ece-student/Team-16/docs/MeetingMinutes/oct27.md

Finished the SPI stuff yesterday, currently working on finishing up lab 4 FPGA stuff.
