ece-student/Team-16/docs/MeetingMinutes/oct13.md

Agenda
* Continue working on lab3
    Especially try to figure out how the pin connections on the FPGA work
* Work on the report for lab3
