ece-student/Team-16/docs/MeetingMinutes/sep29.md

# Meeting Agenda 

-  **Work on lab3** start looking through the material
-  **Fill out team evaluation form** 
-  **Add more demo for milestone2** 

Graphics team | Acoustic team
------------ | -------------
Lois | John
Jidenna | Asad
Firehiwot | Rohit
