ece-student/Team-16/docs/MeetingMinutes/sep22.md

Meeting Minute 9/22

  * We moved around some things on the Milestone 1.
  
  * Added the circuit diagram to the Milestone.
  
  * Finish up Lab 2 writeup  
  
  * We started soldering the filter amp to make it more compact
  
  * We also started the 2nd milestone but we completed one sensor
  
### Next:
  * 2 side sensors and turn mechanism
  * Finish soldering
  * Rearrange wiring 

Meet tomorrow at 3PM
