ece-student/Team-16/docs/MeetingMinutes/sep2.md

Meeting minutes 9/2
Meeting day will be Tuesday 7pm ECE lounge

The lab will be graded in terms of the following: [Lab Grading](https://cei-lab.github.io/ece3400/Grading/Lab_score.html) 

## Task Division

* 2 points: Blinking an internal LED - (Jidenna)

* 2 points: Blinking an external LED- (Jidenna)

* 2 points: Reading the value of a potentiometer via the serial port (Asad)

* 2 points: Map the value of the potentiometer to the LED (Lois)

* 2 points: Map the value of the potentiometer to the servo (Firehiwot)

* 2 points: Assemble your robot (Rohit)

* 3 points: Driving your robot autonomously (John)

[CALENDAR](https://teamup.com/kshx1ageh1yif5gske)
