ece-student/Team-16/docs/MeetingMinutes/nov27.md

Meeting minute 11/27
Last week things to do
  * Backtracking algorithm
  * Rewiring
  * Radio communication
  * Start signal from mic
  * Merging codes and DFS algorithm
  * Mux
  
 Hardware Team
 * Jidenna
 * Asad
 * John
 
 Software Team
 * Lois 
 * Rohit
 * Firehiwot
 
 Final Report
 * Make graphics for robot and overall system
 * Explain hardaware components
 * Explain about issues ecountered during design
 * Take measurements of robot speed, line sensor threshold ...
