ece-student/Team-16/docs/FinalSystemDesign/after2.png

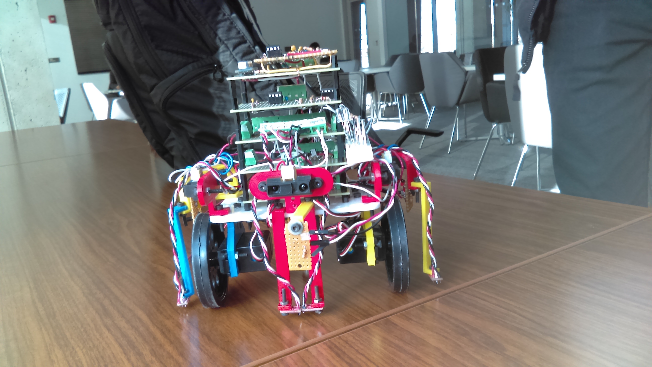
docs/FinalSystemDesign/after2.png
