ece-student/Team-16/docs/FinalSystemDesign/meme.png

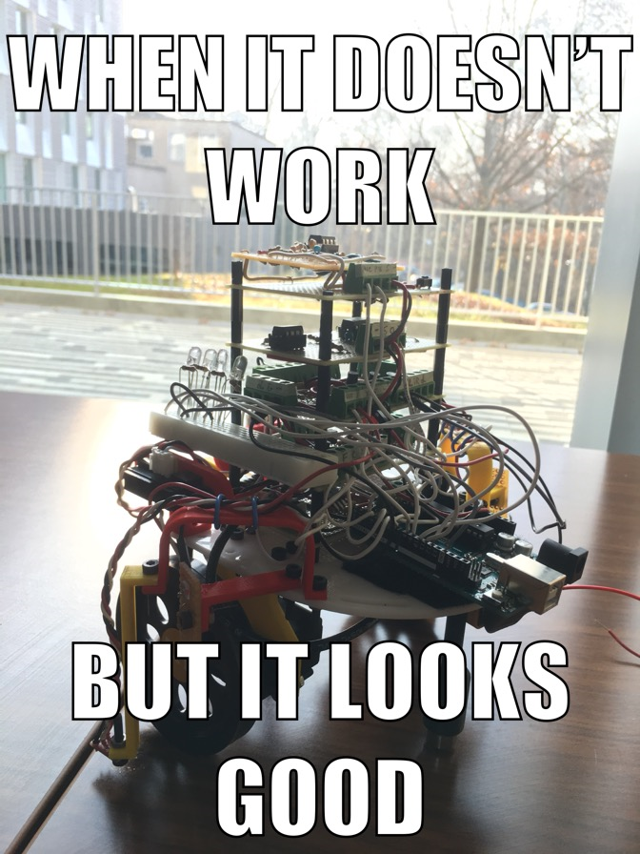
docs/FinalSystemDesign/meme.png
