ece-student/Team-16/docs/FinalSystemDesign/WallSensorAmplifier.png

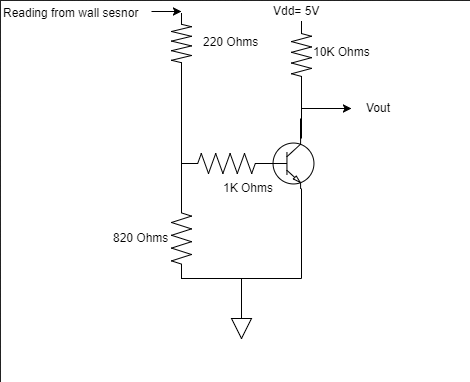
docs/FinalSystemDesign/WallSensorAmplifier.png
