ece-student/Team-16/docs/FinalSystemDesign/z.png

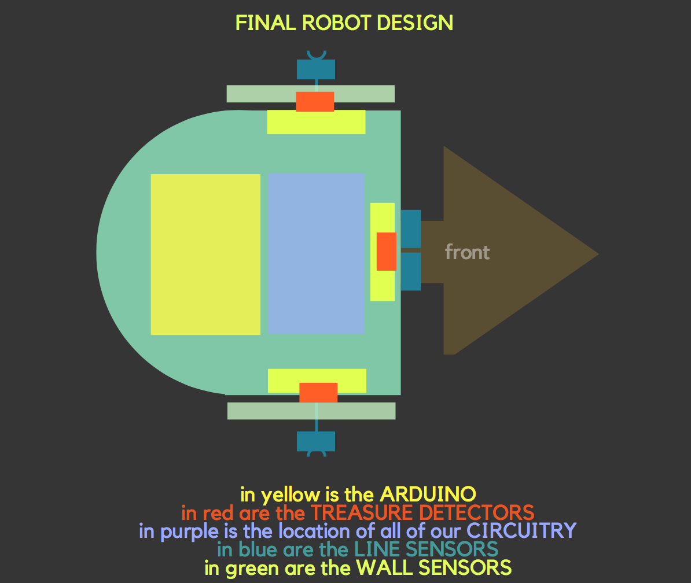
docs/FinalSystemDesign/z.png
