ece-student/Team-16/docs/lab1/imagesLab1/PotReading.png

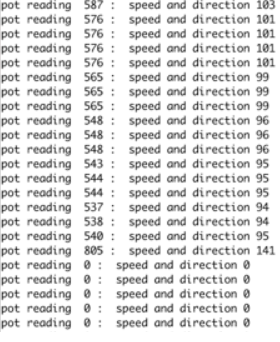
docs/lab1/imagesLab1/PotReading.png
