ece-student/Team-16/docs/lab1/imagesLab1/ServoandPot.png

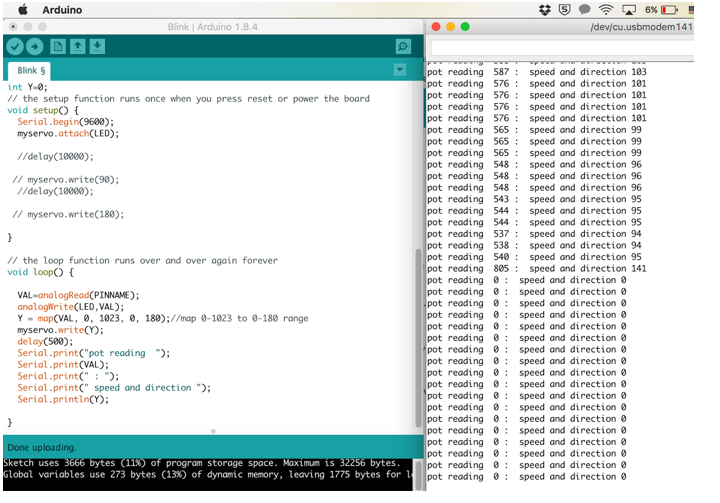
docs/lab1/imagesLab1/ServoandPot.png
