ece-student/Team-16/docs/lab2/1fdf49493ff94520a2393f6a7851c8cf.jpeg

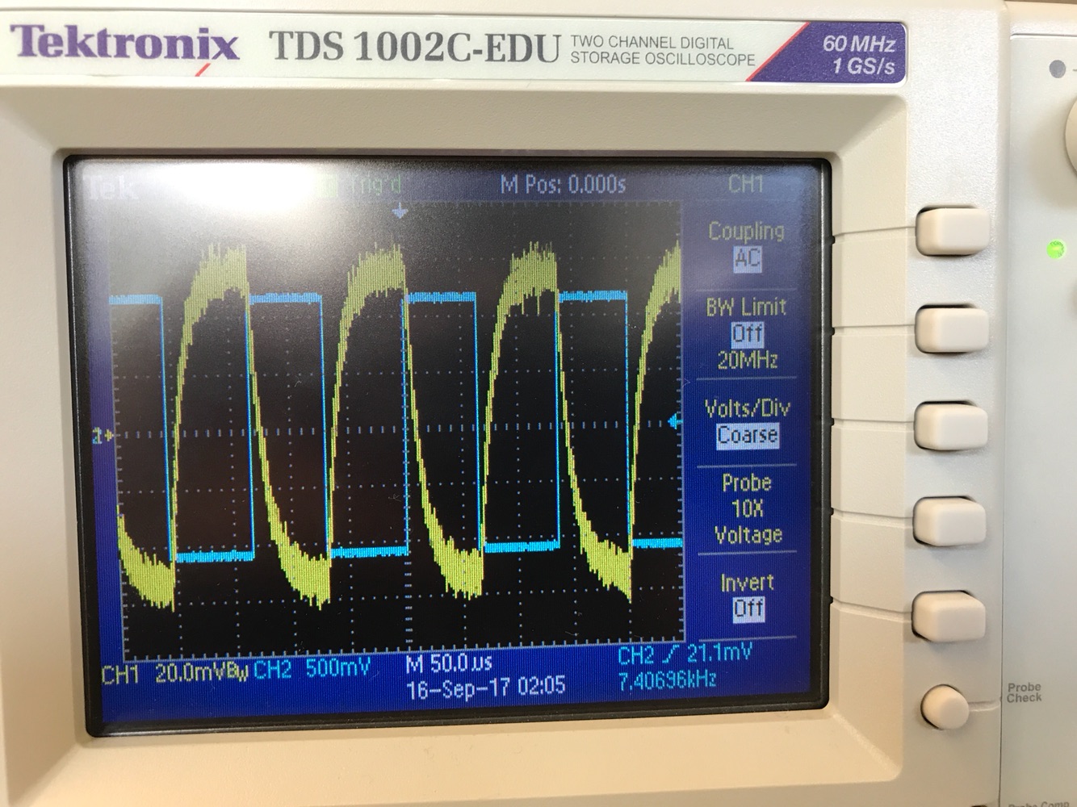
docs/lab2/1fdf49493ff94520a2393f6a7851c8cf.jpeg
