ece-student/Team-16/docs/lab2/baba.png

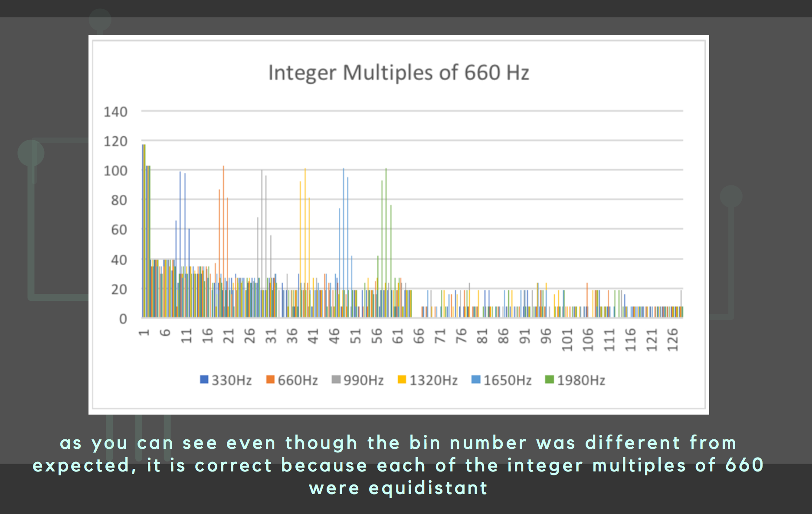
docs/lab2/baba.png
