ece-student/Team-16/docs/lab2/circuit.png

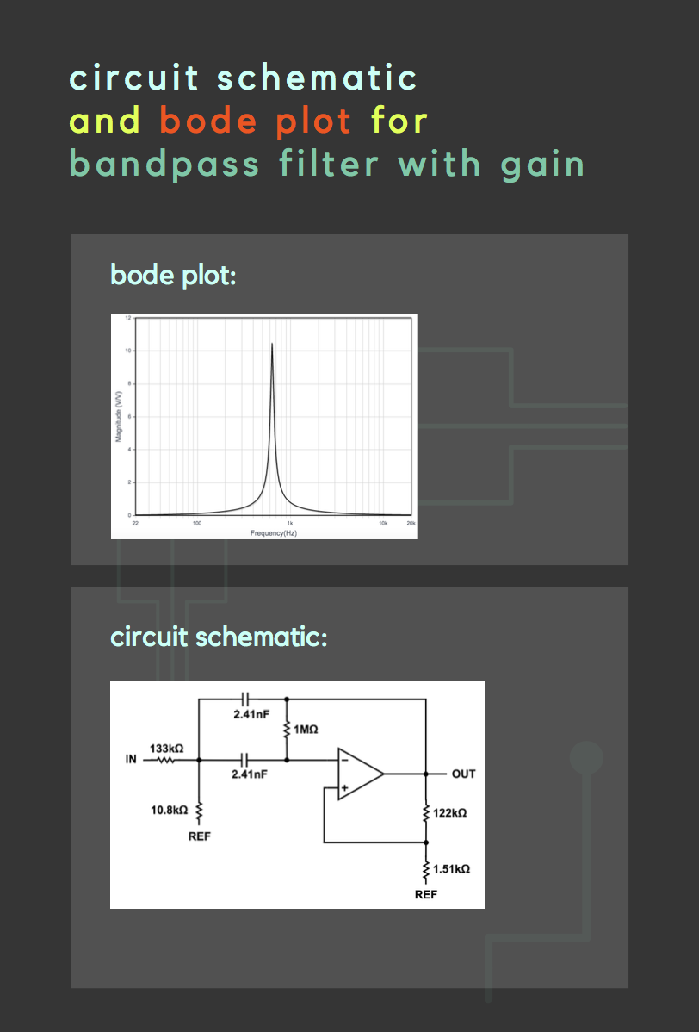
docs/lab2/circuit.png
