ece-student/Team-16/docs/lab2/d4d60459c0ec4c0591ddcf63fce9333b.jpeg

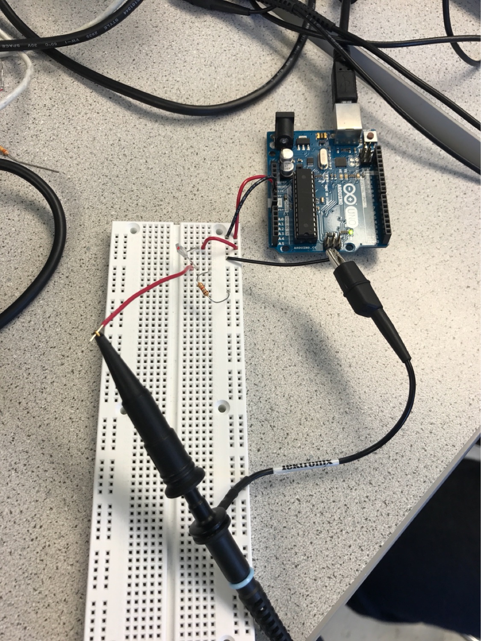
docs/lab2/d4d60459c0ec4c0591ddcf63fce9333b.jpeg
