ece-student/Team-16/docs/lab2/fun_gen.jpg

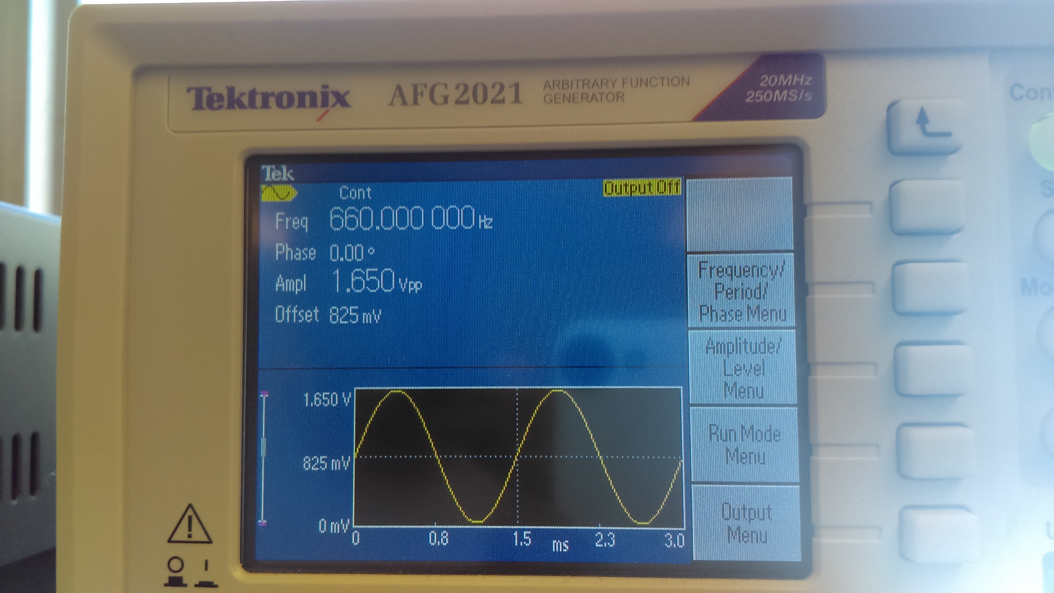
docs/lab2/fun_gen.jpg
