ece-student/Team-16/docs/lab3/acoustic_pics/Photo Oct 13, 3 56 24 PM (1).jpg

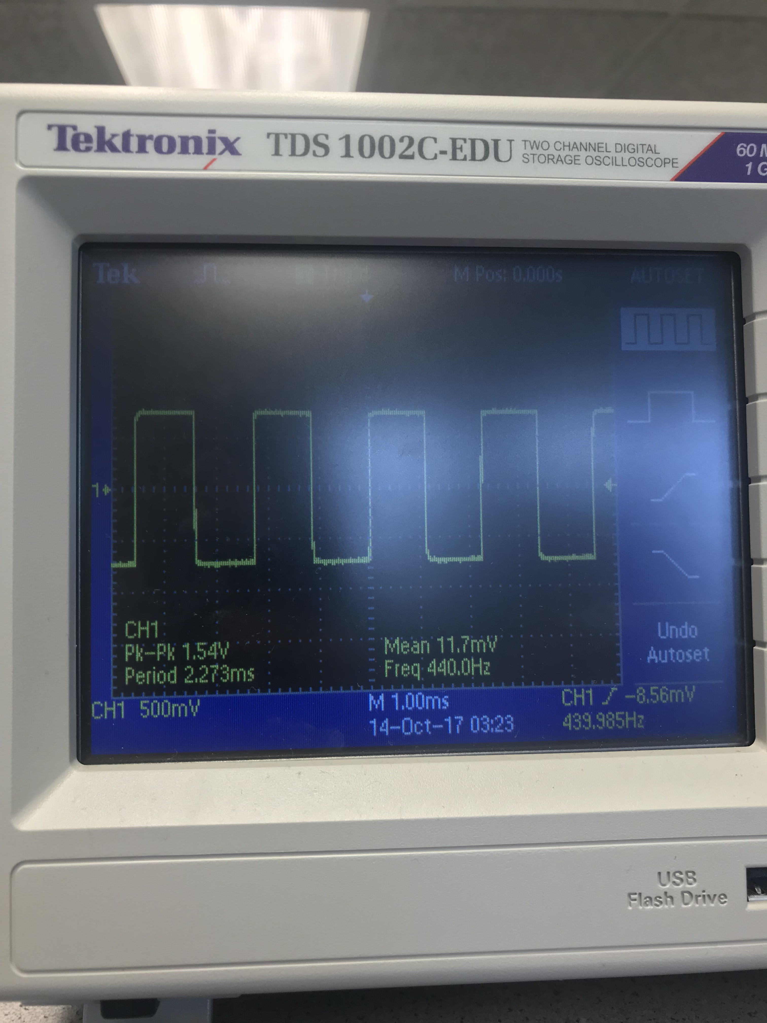
docs/lab3/acoustic_pics/Photo Oct 13, 3 56 24 PM (1).jpg
