ece-student/Team-16/docs/lab3/acoustic_pics/Photo Oct 13, 3 57 23 PM (1).jpg

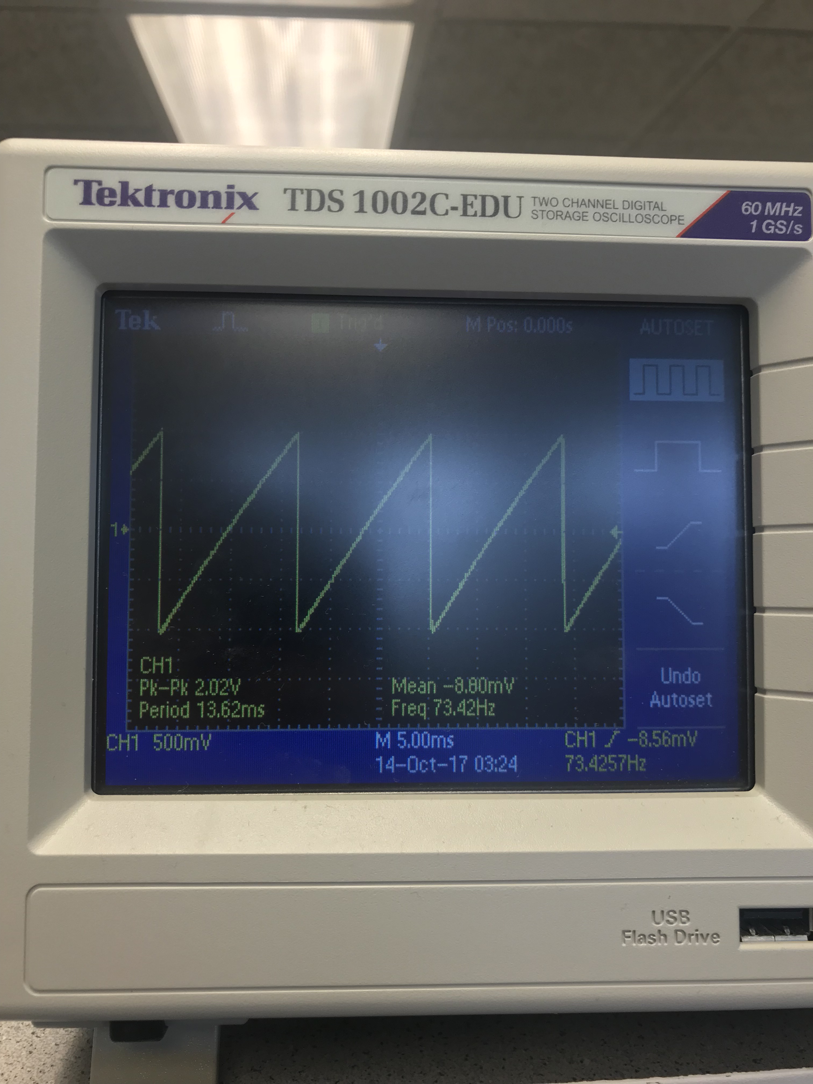
docs/lab3/acoustic_pics/Photo Oct 13, 3 57 23 PM (1).jpg
