ece-student/Team-16/docs/lab3/acoustic_pics/Photo Oct 13, 3 59 01 PM.jpg

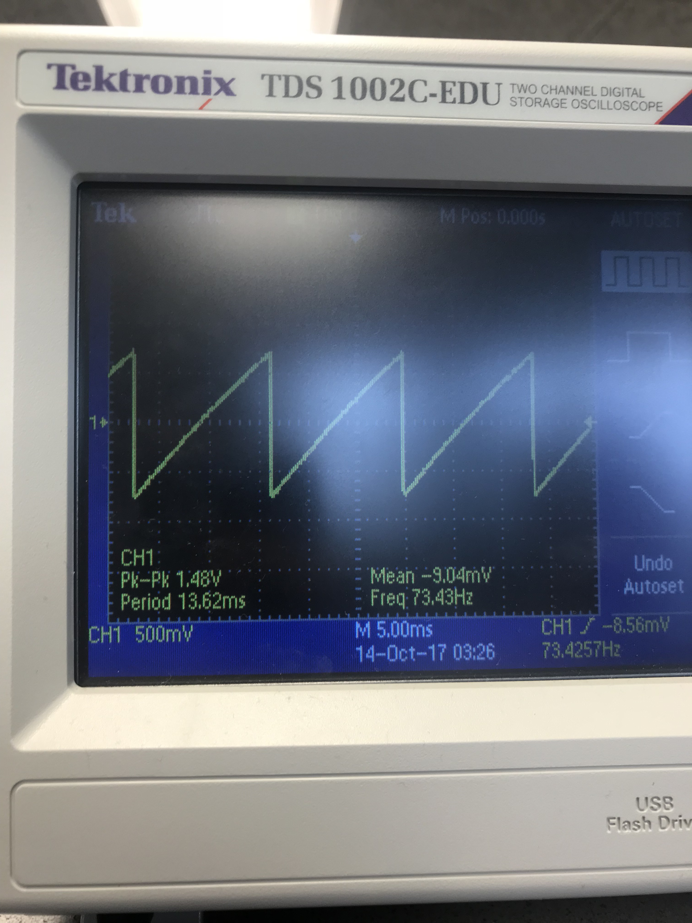
docs/lab3/acoustic_pics/Photo Oct 13, 3 59 01 PM.jpg
