ece-student/Team-16/docs/lab4/1.png

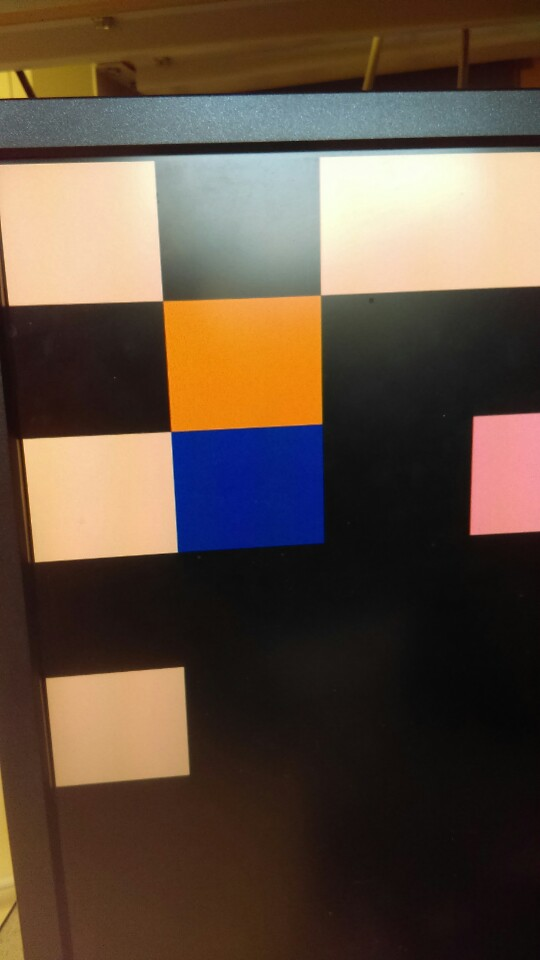
docs/lab4/1.png
