ece-student/Team-16/docs/lab4/2.png

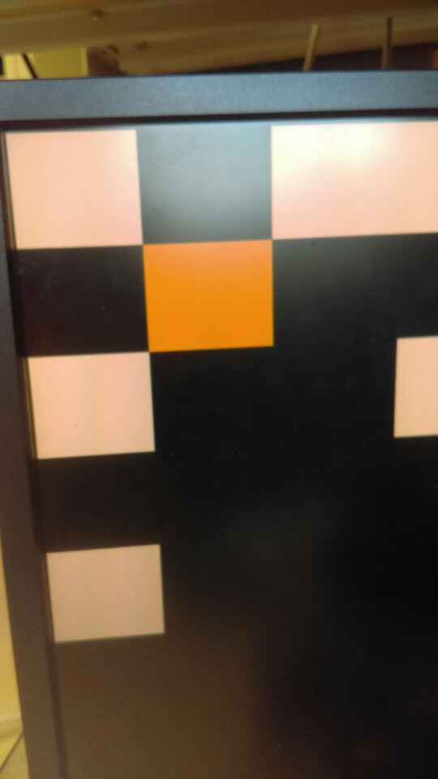
docs/lab4/2.png
