ece-student/Team-16/docs/lab4/VGA Display Pics/Image-1-3.jpg

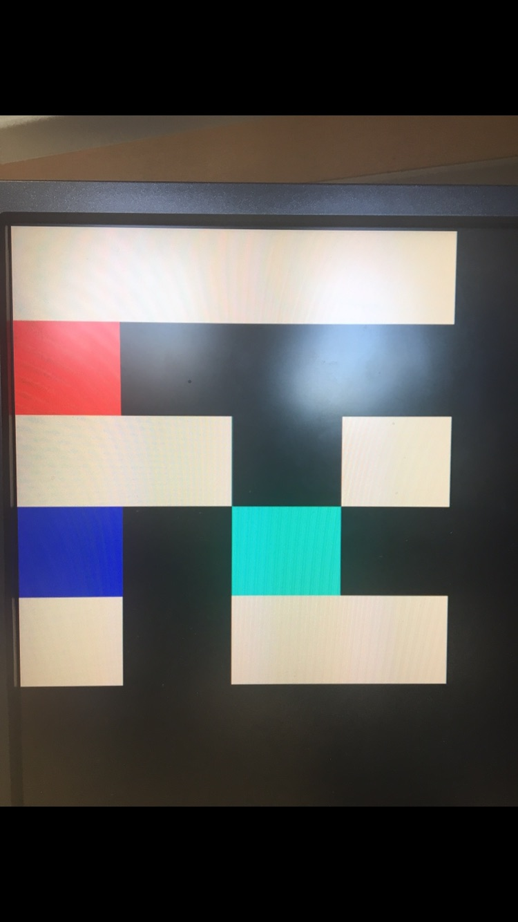
docs/lab4/VGA Display Pics/Image-1-3.jpg
