ece-student/Team-16/docs/milestone4/z1.png

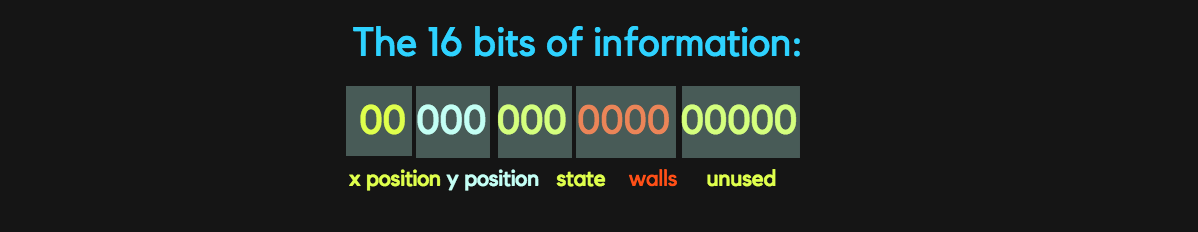
docs/milestone4/z1.png
