ece-student/Team-16/docs/milestone4/z2.png

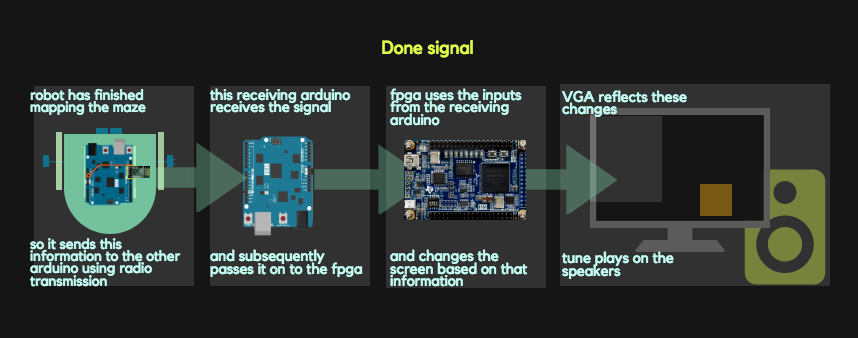
docs/milestone4/z2.png
