ece-student/Team-16/h/j.png

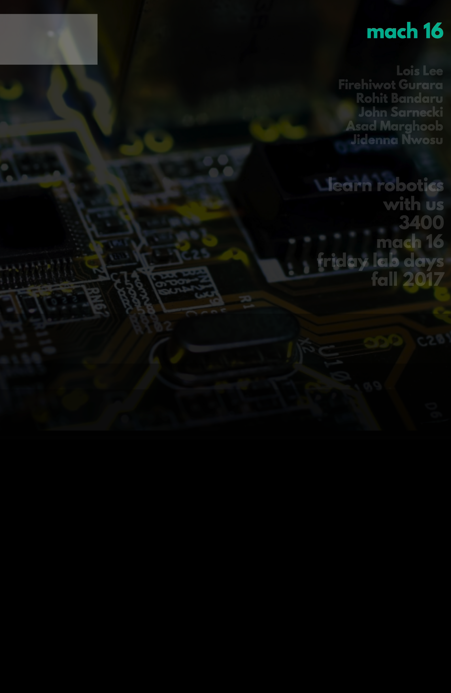
h/j.png
