ece-student/Team-16/h/mach.png

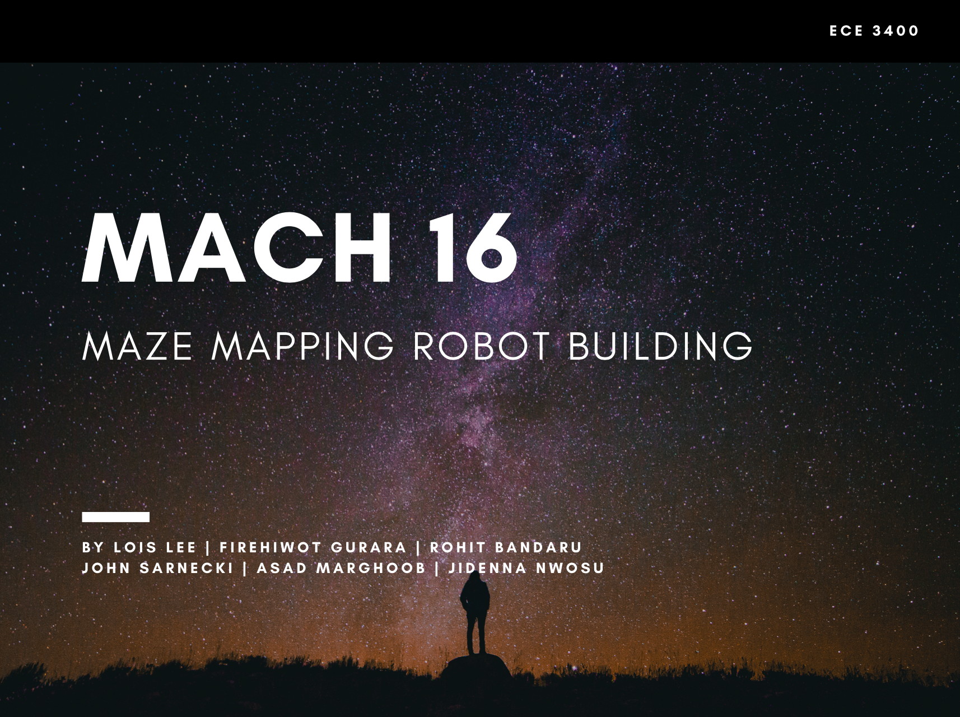
h/mach.png
