ece-student/Team-16/h/t.png

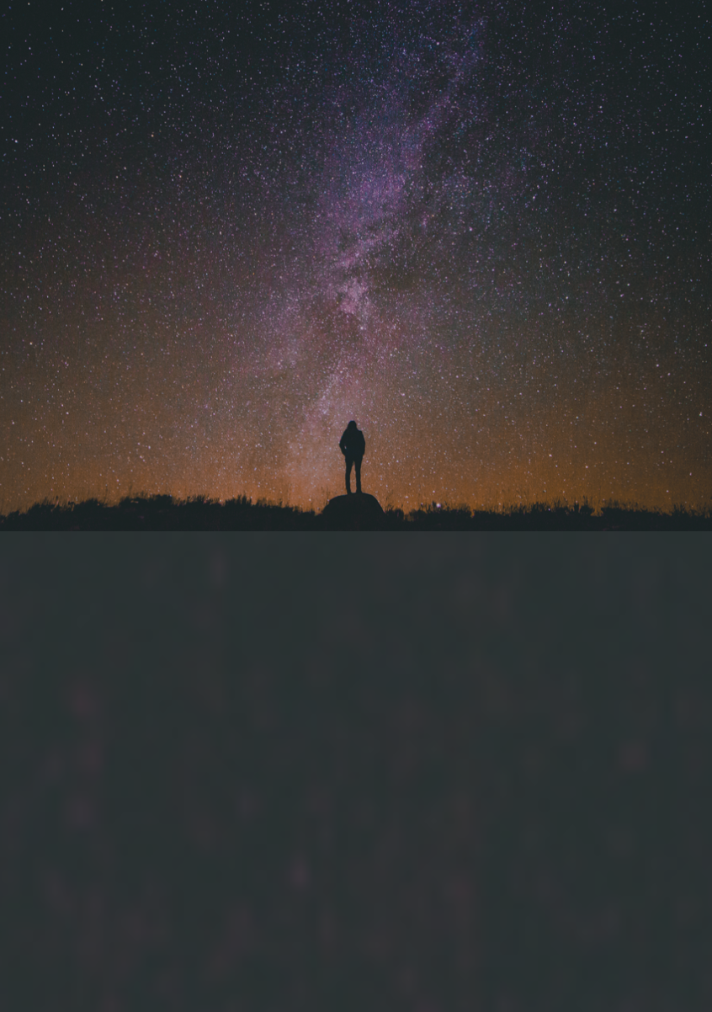
h/t.png
