ece-student/Team-16/docs/Milestone3/realDFS/changes.txt

if (robotX == NULL && robotY == NULL) {
      robotX = 3;
      robotY = 4;
      visited[robotY][robotX] = 6;
    } 
    else {
      visited[yfront][xfront]=6;
      visited[robotY][robotX] = 1;
      robotX = xfront;
      robotY = yfront;
    }    
    
    if (robotX == NULL && robotY == NULL) {
      robotX = 3;
      robotY = 4;
      visited[robotY][robotX] = 6;
    } 
    else {
      visited[yleftt][xleftt]=6;
      visited[robotY][robotX] = 1;
      robotX = xleftt;
      robotY = yleftt;
    }    

word assemble(word x, word y) {
word xShift = x;
xShift << 14;
word yShift = y;
yShift << 11;
word base = xShift || yShift;
base = base || (visited[y][x] << 8);
base = base || (wall[y][x] << 4); 
}
