ece-student/Team-16/docs/milestone4/finalized_robot_code/dumdum.ino

/* 
 *    Maze mapping Robot
 *  
 *  
 *  
 *  
 *  
 */

#include <Servo.h>


/**************************************************************************************Pin assignments*/
// Pin Assignments
const int rightServoPin = 6;
const int leftServoPin = 5;

const int middleRightPin = A2;
const int middleLeftPin = A1;
const int outerRightPin = A5;
const int outerLeftPin = A3;

const int ledPin = 13;

const int frontWall = 4;
const int leftWall = 3;
const int rightWall = 7;

Servo rightServo;
Servo leftServo; 


// Constants
#define WALL_NORTH  1 // 0001
#define WALL_EAST   2 // 0010
#define WALL_SOUTH  4 // 0100
#define WALL_WEST   8 // 1000

const int threshold = 800; 

const int delayTime = 2;

typedef enum {
              NORTH = 1,
              EAST  = 2,
              SOUTH = 4,
              WEST  = 8,
              } ORIENTATION;

typedef enum {
              FORWARD = 0,
              LEFT  = 1,
              RIGHT = 2,
              } TURN;

/*************************************************************************************Global variables*/
// Global Variables
int leftServoAngle = 90;
int rightServoAngle = 90;

int middleLeftVal = 0;
int middleRightVal = 0;
int outerLeftVal = 0;
int outerRightVal = 0;

int visitedBox = 0;

byte robotX = 3;
byte robotY = 4;

byte pastPosX = NULL;
byte pastPosY = NULL;

byte robotOrientation = NORTH;

byte xleft=robotX;
byte yleft=robotY;
byte xfront=robotX;
byte yfront=robotY;
byte xright=robotX;
byte yright=robotY;
byte xback=robotX;
byte yback=robotY;

bool detectNoFWall = true;
bool detectNoRWall = true;
bool detectNoLWall = true;
bool accessGranted = false;
bool doOpposite    = true;

//so goes front, left, right, opposite don't care about visited only walls
//how keep index?
//how know done? 
//is stack necessary?

byte visited[5][4] =  {{0,0,0,0},
                       {0,0,0,0},
                       {0,0,0,0},
                       {0,0,0,0},
                       {0,0,0,6}};

byte wall[5][4] = {{9,1,1,3},
                   {8,0,0,2},
                   {8,0,0,2},
                   {8,0,0,2},
                   {12,4,4,6}};


int rightServoMap(int angle) {
  int newAngle = 180 - angle;
  return newAngle;
}

void rightOrientation(){
  if(robotOrientation == NORTH){
    robotOrientation = EAST;
  }
  else if(robotOrientation == EAST) {
    robotOrientation = SOUTH;
  }
  else if(robotOrientation == SOUTH) {
    robotOrientation = WEST;
  }
  else if(robotOrientation == WEST) {
    robotOrientation = NORTH;
  }
}

void leftOrientation(){
  if(robotOrientation == NORTH){
    robotOrientation = WEST;
  }
  else if(robotOrientation == WEST) {
    robotOrientation = SOUTH;
  }
  else if(robotOrientation == SOUTH) {
    robotOrientation = EAST;
  }
  else if(robotOrientation == EAST) {
    robotOrientation = NORTH;
  }
}

bool withinMazeX(byte xCoord) {
  if(xCoord > 3 || xCoord < 0) {
    return false;
  } else {
    return true;
  } 
}

bool withinMazeY(byte yCoord) {
  if(yCoord > 4 || yCoord < 0) {
    return false;
  } else {
    return true;
  } 
}

//OK
void neighbourIndex(){
  if(robotOrientation == NORTH){
     xleft=robotX-1;
     yleft=robotY;
     xfront=robotX;
     yfront=robotY-1;
     xright=robotX+1;
     yright=robotY;
     xback=robotX;
     yback=robotY+1;
  }
  if(robotOrientation == EAST) {
     xleft=robotX;
     yleft=robotY-1;
     xfront=robotX+1;
     yfront=robotY;
     xright=robotX;
     yright=robotY+1;
     xback=robotX-1;
     yback=robotY;
  }
  if(robotOrientation == SOUTH) {
     xleft=robotX+1;
     yleft=robotY;
     xfront=robotX;
     yfront=robotY+1;
     xright=robotX-1;
     yright=robotY;
     xback=robotX;
     yback=robotY-1;
  }
  if(robotOrientation == WEST) {
     xleft=robotX;
     yleft=robotY+1;
     xfront=robotX-1;
     yfront=robotY;
     xright=robotX;
     yright=robotY-1;
     xback=robotX+1;
     yback=robotY;
  }
  if (robotX==NULL  && robotY==NULL){
    xfront=3;
    yfront=4;
  }
}


/***********************************************************************************Movement functions*/

//Need to verify when to update robot current position
void rightTurn() {
  leftServoAngle = 180;
  rightServoAngle = rightServoMap(0);
  leftServo.write(leftServoAngle);
  rightServo.write(rightServoAngle);
  delay(400);

  while ((analogRead(outerLeftPin) < threshold) && (analogRead(outerRightPin) < threshold)){
    leftServo.write(leftServoAngle);
    rightServo.write(rightServoAngle);
    delay(delayTime);
  }
  
  rightServoAngle = rightServoMap(180);
  leftServoAngle = 180;
  leftServo.write(leftServoAngle);
  rightServo.write(rightServoAngle);
  delay(200);

  rightOrientation();
  visited[yright][xright] = 6;
  visited[robotY][robotX] = 1;
  robotX = xright;
  robotY = yright;
}

//Need to verify when to update robot current position
void opposite() {
  leftServoAngle = 180;
  rightServoAngle = rightServoMap(0);
  leftServo.write(leftServoAngle);
  rightServo.write(rightServoAngle);
  delay(400);
  while ((analogRead(outerLeftPin) < threshold) && (analogRead(outerRightPin) < threshold)){
    leftServo.write(leftServoAngle);
    rightServo.write(rightServoAngle);
    delay(delayTime);
  }
  leftServoAngle = 180;
  rightServoAngle = rightServoMap(0);
  leftServo.write(leftServoAngle);
  rightServo.write(rightServoAngle);
  delay(400);
  while ((analogRead(outerLeftPin) < threshold) && (analogRead(outerRightPin) < threshold)){
    leftServo.write(leftServoAngle);
    rightServo.write(rightServoAngle);
    delay(delayTime);
  }
  rightServoAngle = rightServoMap(180);
  leftServoAngle = 180;
  leftServo.write(leftServoAngle);
  rightServo.write(rightServoAngle);
  delay(200);

  rightOrientation();
  rightOrientation();
  visited[yback][xback] = 6;
  visited[robotY][robotX] = 1;
  robotX = xback;
  robotY = yback;
}

//Need to verify when to update robot current position 
void leftTurn(){
  leftServoAngle = 0;
  rightServoAngle = rightServoMap(180);
  leftServo.write(leftServoAngle);
  rightServo.write(rightServoAngle);
  delay(400);
  while ((analogRead(outerLeftPin) < threshold) && (analogRead(outerRightPin) < threshold)){
    leftServo.write(leftServoAngle);
    rightServo.write(rightServoAngle);
    delay(delayTime);
  }  
  rightServoAngle = rightServoMap(180);
  leftServoAngle = 180;
  leftServo.write(leftServoAngle);
  rightServo.write(rightServoAngle);
  delay(200);
  leftOrientation();
  
    if (robotX == NULL && robotY == NULL) {
      robotX = 3;
      robotY = 4;
      visited[robotY][robotX] = 6;
    } 
    else {
      visited[yleft][xleft]=6;
      visited[robotY][robotX] = 1;
      robotX = xleft;
      robotY = yleft;
    }    

}

//OK
void lineFollow(){
      if ((middleLeftVal > threshold) && (middleRightVal < threshold)) {
        rightServoAngle = rightServoMap(180);
        leftServoAngle = 95;
        rightServo.write(rightServoAngle);
        leftServo.write(leftServoAngle);
        delay(delayTime);
      }
  
      if ((middleLeftVal < threshold) && (middleRightVal > threshold)) {
        rightServoAngle = rightServoMap(95);
        leftServoAngle = 180;
        rightServo.write(rightServoAngle);
        leftServo.write(leftServoAngle);
        delay(delayTime);
      }
  
      if ((middleLeftVal > threshold) && (middleRightVal > threshold)) {
        rightServoAngle = rightServoMap(180);
        leftServoAngle = 180;
        rightServo.write(rightServoAngle);
        leftServo.write(leftServoAngle);
        delay(delayTime);
      }    
}

//Need  to verify when to update robot current position
void goStraight(){
    rightServoAngle = rightServoMap(180);
    leftServoAngle = 180;
    rightServo.write(rightServoAngle);
    leftServo.write(leftServoAngle);
    delay(150);
    
if (robotX == NULL && robotY == NULL) {
      robotX = 3;
      robotY = 4;
      visited[robotY][robotX] = 6;
    } 
    else {
      visited[yfront][xfront]=6;
      visited[robotY][robotX] = 1;
      robotX = xfront;
      robotY = yfront;
    }    
    

}



void stopRobot(){
    rightServo.write(rightServoMap(90));
    leftServo.write(90);  
    delay(100);
}

//OK
/*********************************************************************************************Light up*/
void lightUp(){
  // check if done with maze, aka, all have been visited
  pinMode (ledPin, HIGH);
}

//OK
byte wallOrientation() {
  byte wall = 0;
  if(robotOrientation == NORTH) {
    if(!detectNoFWall){
      wall |= NORTH;
    }
    if(!detectNoLWall){
      wall |= WEST;
    }
    if(!detectNoRWall){
      wall |= EAST;
    }  
  }
  else if(robotOrientation == EAST) {
    if(!detectNoFWall){
      wall |= EAST;
    }
    if(!detectNoLWall){
      wall |= NORTH;
    }
    if(!detectNoRWall){
      wall |= SOUTH;
    } 
  }
  else if(robotOrientation == SOUTH) {
    if(!detectNoFWall){
      wall |= SOUTH;
    }
    if(!detectNoLWall){
      wall |= EAST;
    }
    if(!detectNoRWall){
      wall |= WEST;
    } 
  }
  else if(robotOrientation == WEST) {
    if(!detectNoFWall){
      wall |= WEST;
    }
    if(!detectNoLWall){
      wall |= SOUTH;
    }
    if(!detectNoRWall){
      wall |= NORTH;
    } 
  }
  return wall;  
}

//Need to check where to place this function
void updateWallMatrix() {
  wall[robotY][robotX] = wallOrientation(); 
}



void setup() {
  rightServo.attach(rightServoPin);
  leftServo.attach(leftServoPin);
  leftServoAngle = 90;
  rightServoAngle = rightServoMap(90);

  pinMode(frontWall, INPUT);
  pinMode(rightWall, INPUT);
  pinMode(leftWall, INPUT);
  pinMode(ledPin, OUTPUT);

  Serial.begin(9600);
  
  rightServo.write(rightServoAngle);
  leftServo.write(leftServoAngle);
  delay(2000); //Wait 2 seconds
}


/*************************************************************************************************Loop*/
void loop() { 

  //Could combine outer left and outer right line sensors 
  // greater than 750 on the line
  // less than 750 off the line
  middleLeftVal = analogRead(middleLeftPin);
  middleRightVal = analogRead(middleRightPin);
  outerLeftVal = analogRead(outerLeftPin);
  outerRightVal = analogRead(outerRightPin);
  
  lineFollow();
  
  //Detect walls
  detectNoFWall = digitalRead(frontWall);
  detectNoRWall = digitalRead(rightWall);
  detectNoLWall = digitalRead(leftWall);

  if((outerLeftVal > threshold) && (outerRightVal > threshold)){
    for (int i=0; i<5; i++){
      for (int j=0; j<4; i++){
       if (visited[robotY][robotX]==1){
        visitedBox++;
       }
    }
  }
    if (visitedBox==20){
      stopRobot();
    }
    else{
    visitedBox=0;
      Serial.println(digitalRead(frontWall));


    if (robotOrientation == NORTH){
    Serial.println("NORTH");
    }
    else if (robotOrientation == EAST) {
    Serial.println("EAST");
    }
    else if (robotOrientation == SOUTH) {
    Serial.println("SOUTH");
    }
    else if (robotOrientation == WEST) {
    Serial.println("WEST");
    }

    
  //DFS
    neighbourIndex();   
    updateWallMatrix();
   
    if (detectNoFWall && withinMazeX(xfront) && withinMazeY(yfront)) { 
      Serial.println("going straight!");       
      
      goStraight();
      
    }
    else if (detectNoLWall && withinMazeX(xleft) && withinMazeY(yleft)) {
      Serial.println("turn left");
      leftTurn();

    } 
    else if (detectNoRWall && withinMazeX(xright) && withinMazeY(yright)) {
      Serial.println("turn right");
      rightTurn();     
      
    } 
    else {
      Serial.println("going opposite!");
      opposite();


    }
  }
  }
  else{
    lightUp();

  }

}
  
