ece-student/Team-16/docs/milestone2/WallDetect.ino

/* 
 *    Line Following Robot
 *  
 *  
 *  
 *  
 *  
 */

#include <Servo.h>

//This array tells the robot when to turn at each
//intersection given a start location. A 0 means
//keep going forward at an intersection. A 1 means
//turn left at an intersection. A 2 means turn right
//at an intersection.
int turns[] = {0,2,2,2,0,1,1,1};
int intersection = 0;

Servo rightServo;
Servo leftServo; 

const int rightServoPin = 6;
const int leftServoPin = 5;

const int middleRightPin = A0;
const int middleLeftPin = A1;
const int outerRightPin = A2;
const int outerLeftPin = A3;

const int ledPin = 13;
const int frontWall = 8;

const int threshold = 800; 

const int delayTime = 2;

int leftServoAngle = 90;
int rightServoAngle = 90;

int middleLeftVal = 0;
int middleRightVal = 0;
int outerLeftVal = 0;
int outerRightVal = 0;

bool detectNoFWall = true;

int rightServoMap(int angle) {
  int newAngle = 180 - angle;
  return newAngle;
}

void rightturn() {
  leftServoAngle = 180;
  rightServoAngle = rightServoMap(0);
  leftServo.write(leftServoAngle);
  rightServo.write(rightServoAngle);
  delay(300);

  while ((analogRead(outerLeftPin) < threshold) && (analogRead(outerRightPin) < threshold)){
    leftServo.write(leftServoAngle);
    rightServo.write(rightServoAngle);
    delay(delayTime);
  }
  
  rightServoAngle = rightServoMap(180);
  leftServoAngle = 180;
  leftServo.write(leftServoAngle);
  rightServo.write(rightServoAngle);
  delay(200);
    
  intersection += 1;
}

void leftturn(){
  leftServoAngle = 0;
  rightServoAngle = rightServoMap(180);
  leftServo.write(leftServoAngle);
  rightServo.write(rightServoAngle);
  delay(300);

  while ((analogRead(outerLeftPin) < threshold) && (analogRead(outerRightPin) < threshold)){
    leftServo.write(leftServoAngle);
    rightServo.write(rightServoAngle);
    delay(delayTime);
  }
  
  rightServoAngle = rightServoMap(180);
  leftServoAngle = 180;
  leftServo.write(leftServoAngle);
  rightServo.write(rightServoAngle);
  delay(200);
  
  intersection += 1;
}

void setup() {
  rightServo.attach(rightServoPin);
  leftServo.attach(leftServoPin);
  
  //Serial.begin(9600);

  leftServoAngle = 90;
  rightServoAngle = rightServoMap(90);

  pinMode(frontWall, INPUT);
  pinMode(ledPin, OUTPUT);

  rightServo.write(rightServoAngle);
  leftServo.write(leftServoAngle);
  delay(2000); //Wait 2 seconds
}

void loop() {
  /*Serial.print("outer Left "); 
  Serial.print(analogRead(outerLeftPin));
  Serial.print("outer Right ");
  Serial.print(analogRead(outerRightPin));
  Serial.print("middle Left ");
  Serial.print(analogRead(middleLeftPin));
  Serial.print("middle Right ");
  Serial.println(analogRead(middleRightPin));*/
  
  middleLeftVal = analogRead(middleLeftPin);
  middleRightVal = analogRead(middleRightPin);
  outerLeftVal = analogRead(outerLeftPin);
  outerRightVal = analogRead(outerRightPin);

  detectNoFWall = digitalRead(frontWall);
  /*
  rightServoAngle = rightServoMap(180);
  leftServoAngle = 180;
  rightServo.write(rightServoAngle);
  leftServo.write(leftServoAngle);
  */
  //delay(5);
  
  // greater than 750 on the line
  // less than 750 off the line

   
  if(!detectNoFWall){
    if ((middleLeftVal > threshold) && (middleRightVal < threshold)) {
        rightServoAngle = rightServoMap(180);
        leftServoAngle = 95;
        rightServo.write(rightServoAngle);
        leftServo.write(leftServoAngle);
        delay(delayTime);
      }
  
      if ((middleLeftVal < threshold) && (middleRightVal > threshold)) {
        rightServoAngle = rightServoMap(95);
        leftServoAngle = 180;
        rightServo.write(rightServoAngle);
        leftServo.write(leftServoAngle);
        delay(delayTime);
      }
  
      if ((middleLeftVal > threshold) && (middleRightVal > threshold)) {
        rightServoAngle = rightServoMap(180);
        leftServoAngle = 180;
        rightServo.write(rightServoAngle);
        leftServo.write(leftServoAngle);
        delay(delayTime);
      }
    
  
  // intersection
    if((outerLeftVal > threshold) && (outerRightVal > threshold)){
      if (intersection > 7) {
        intersection = 0;
      }
      //digitalWrite(ledPin, HIGH);
      /*rightServoAngle = rightServoMap(90);
      leftServoAngle = 90;
      rightServo.write(rightServoAngle);
      leftServo.write(leftServoAngle);
      */
      //delay(1000);
      
      int currTurn = turns[intersection];
      if(currTurn == 0){
        rightServoAngle = rightServoMap(180);
        leftServoAngle = 180;
        rightServo.write(rightServoAngle);
        leftServo.write(leftServoAngle);
        delay(150);
        intersection += 1;
      } //straight
      if(currTurn == 1){
        leftturn();
      }
      if(currTurn == 2){
        rightturn();
      }
      digitalWrite(ledPin, LOW);
    }
  } 
  else
  {
    
    rightServo.write(90);
    leftServo.write(90);  
    delay(100);
  }
  
      
  
}
