ece-student/Team-16/(commit log)

2017-09-05 robot assembly
2017-09-05 removed LEDPin variable
2017-09-22 IR sensor schematic
2017-09-22 Added IR Sensor Schematic
2017-09-22 basic circuit description
2017-09-22 fixed spacing around IR schematic
2017-09-22 readded circuit stuff
