ece-student/Team-16/docs/lab1/imagesLab1/IMG_2465.JPG

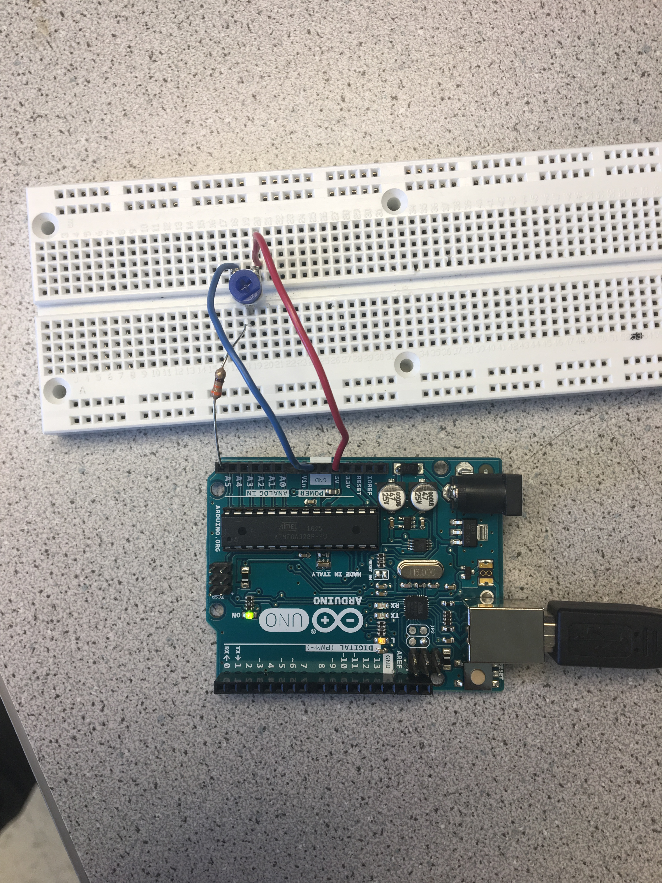
[picture p60: docs/lab1/imagesLab1/IMG_2465.JPG]
docs/lab1/imagesLab1/IMG_2465.JPG
