ece-student/Team-16/docs/lab3/acoustic_pics/IMG_2763.JPG

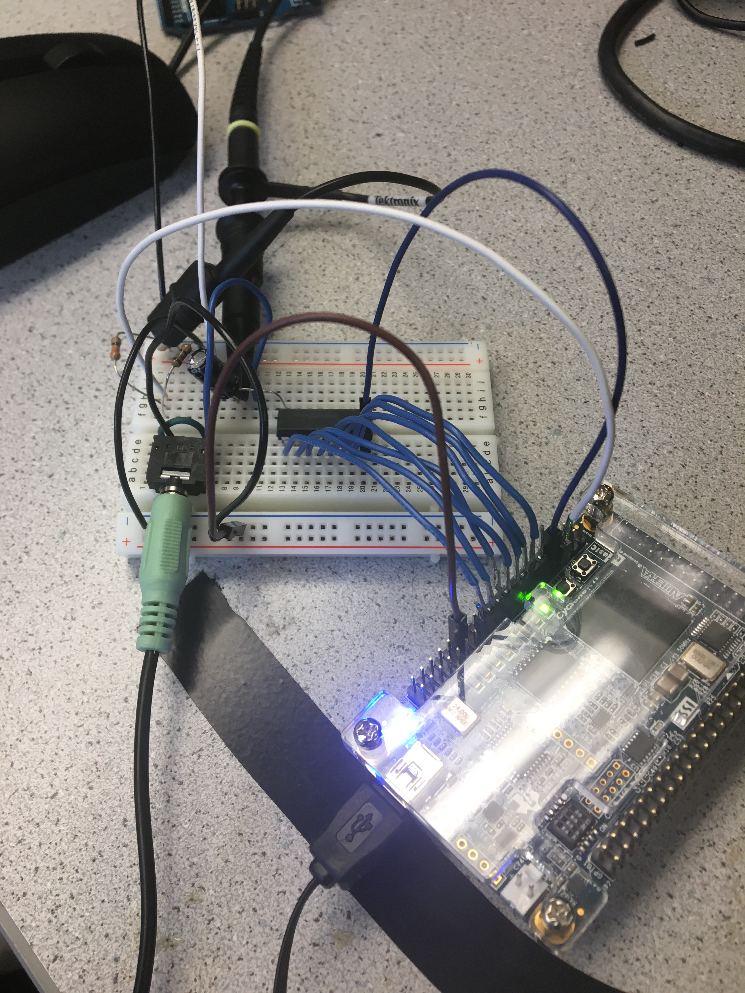
docs/lab3/acoustic_pics/IMG_2763.JPG
